cbachhuber/G2GDelay/(threads)

Thread 1 (2019-03-20):

Tidied up Arduino Code not working anymore

jolau, 2019-03-20:
The tidied up version of the Arduino code doesn't work anymore. I had to use a version from before.

Closed 2021-09-14.

Thread 6 (2021-10-14):

G2G doesn't display 0.00ms anymore when PT is next to LED

vashmata, 2021-10-14:
I noticed that after the latest commits I don't meaure 0.00ms anymore when testing the LED next to the phototransistor.

cbachhuber, 2021-10-16:
Which values are you seeing?

cbachhuber, 2021-10-16:
You sent me per email:

> So I have it printing 0.0ms again and at the right frequency

Hence I'm closing this issue. Feel free to reopen if I understood that wrong 👍

Thread 8 (2021-10-18):

Remove unused PinChangeInt library

vashmata, 2021-10-18:
I noticed that the PinChangeInt library wasn't actually being used in the Arduino code.

Also, the Arduino IDE autoformatter was key in finding the missing curly brace in #2. But it changes a lot of whitespace when it's run and I would like to make those changes here rather than in another issue since the commit will make it look like a lot has changed when really it's just whitespace.

There may be some other minor adjustments as well.

Closed 2021-10-19.

Thread 23 (2024-02-28):

Trouble getting the PT to pick up the lighting up LED on screen

cbachhuber, 2024-02-28:
@wpeirkcfj [wrote](https://github.com/cbachhuber/G2GDelay/issues/15#issuecomment-1965735853)

> I am very interested in your Glass to Glass Delay Measurement System project and bought my own equipment to try to reproduce it. But after setting up this project, I found that during the test delay process, if the system works normally when the LED is placed directly on the PT, it is normal to shoot the LED through the mobile phone screen and then use the PT to receive it, but when the LED is placed The system does not work properly when on the computer screen. PT cannot receive the light displayed by the LED through the computer screen. I was wondering if you could help me with this.
I sincerely appreciate your help and guidance.

Let's discuss his request in this issue.

cbachhuber, 2024-02-28:
To me, this sounds like the threshold might be too high. Can you try the following things to troubleshoot

- What's listed [here](https://github.com/cbachhuber/G2GDelay?tab=readme-ov-file#troubleshooting)
- Ensure that the [correct side of the PT is facing the screen](https://github.com/cbachhuber/G2GDelay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)
- Try lowering [these thresholds](https://github.com/cbachhuber/G2GDelay/blob/master/Arduino_code/Arduino_code.ino#L17-L18) and see if the system picks up the delay. Careful: too low values may make the system reactto noise.
- If nothing above works, you can debug yourself: you can print the brightness values that the PT sees over time by printing [these values](https://github.com/cbachhuber/G2GDelay/blob/57c546cb53987db089dadcfdd840e663ccd23c40/Arduino_code/Arduino_code.ino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). Consider printing them to a terminal and plotting them. This curve should be mostly constant, with a jump in value when the LED is turning on from the PT's perspective.
