cbachhuber/G2GDelay/(commit log)

2018-08-02 Inserted bibtex entry
2018-11-20 Tidy up Arduino code
2021-09-14 Add missing parenthesis and RAW_VALUES definition
    [Arduino_code.ino]
2021-10-15 Update readme to be specific about A0 pin
2021-10-18 Fix line in setup() that initializes i_ledOFF incorrectly
    [Arduino_code.ino]
2021-10-26 Build Arduino sktech in CI (#16)
2021-10-30 Revert "Expressive function names"
    This reverts commit 3e49ff2c6dbd302cea6edae08ada9d88ea8dcb8c.
    [delayrecorder.py]
2021-10-30 Revert "Revert "Expressive function names""
    This reverts commit 7d3b1365e2d68dc26d02f0bde216ba8d55582c8b.
    [delayrecorder.py]
2021-10-30 Revert "Revert "Revert "Expressive function names"""
    This reverts commit ab2fe07de19f60aa512ae7d743156891f21ed4ca.
    [delayrecorder.py]
2021-10-30 Revert "Tidy up main"
    This reverts commit 50639ccc782e636986881371fa3cc3db49ab7a7f.
    [delayrecorder.py]
